prynth/prynth/pbridge/README.txt

# compile with the following command:

# cd src
# gcc -o pbridge pbridge.c -lwiringPi -llo

#move the binary to the upper directory
# mv ./pbridge ..

#requirements: liblo7, wiringPi, liblo-dev
