prynth/prynth/(threads)

Thread 1 (2016-12-07):

Resistors in schematics have no value specified

geriljaSA, 2016-12-07:
Hi.

The resistors and capacitors also in the schematic have no value (that I could find)

Can you please add to the bill of materials or the schematics the component values?

Thanks!

ifranco, 2016-12-07:
Hi. The resistors don't have specific values because you can use different values.

The resistors you find on the multiplexer boards are pull down resistors, so you should only populate them if you will be using switches instead of variable resistors. In that case, anything between 1K and 10K should be OK.

The capacitor is there mostly for good measure, in case you have big voltage drops. This is  conditioned by the application and shouldn't be necessary, unless you run into any instability when using sensors. In that case you will have to try different values and test.

The only resistor that needs a specific value is the midi out, which isn't really documented, since it doesn't follow the midi specification (3.3V instead of 5V). I tested it briefly but I'm not sure if it is reliable enough. If it is I will write about that feature in the future, at which point I will add the resistance value (by the way, so you know, it should be 47ohms, to have traditional MIDI on +3.3V).

Hope that helps.

geriljaSA, 2016-12-08:
Thanks! That helps a lot. I did not understand why the variable resistors seemed to need a pulldown resistor. But makes sense when you say they are only needed for switches. I just finished putting it together on prototyping board with one multiplexer and some variable resistors for a quick test... and it works 👍 Look forward to play more with this!

Thanks for the good work!

ifranco, 2016-12-08:
I would love to know what you're doing with it with Prynth.
My contacts are on the webpage (https://prynth.github.io/).

Thanks

Closed 2018-03-29.

Thread 3 (2018-04-25):

Changing sampling rate throught the sensor settings page

HarishJayanth, 2018-04-25:
Updating sample rate on the sensor settings page triggers a sensorSelected/ osc message instead of /sampleRate.

ifranco, 2018-04-25:
just fixed. Check it.

Closed 2018-05-10.

Thread 4 (2019-01-05):

osc address label on gui properties page

madskjeldgaard, 2019-01-05:
This is a tiny issue and more of a suggestion: Change the "Name:" label of a gui element in the properties part of the gui page to the same as the equivalent in the sensor page "OSC ADDRESS: /raspberrypi" for ease of use.

Thread 5 (2019-01-08):

Midi pulldown resistor value missing from documentation/eagle files

madskjeldgaard, 2019-01-08:
I am not able to find the value of resistor R1 by the midi output anywhere in the docs nor in the eagle files. Is it 33 ohms? Thanks

ifranco, 2019-01-09:
Hi Mads,Yes, you need to use something around those values.From my
calculations 47 Ohm is actually more appropriate.
Cheers,Ivan

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
