prynth/prynth/pcb/control/eagle/control.brd

## EAGLE design pcb/control/eagle/control.brd (2018-05-30)

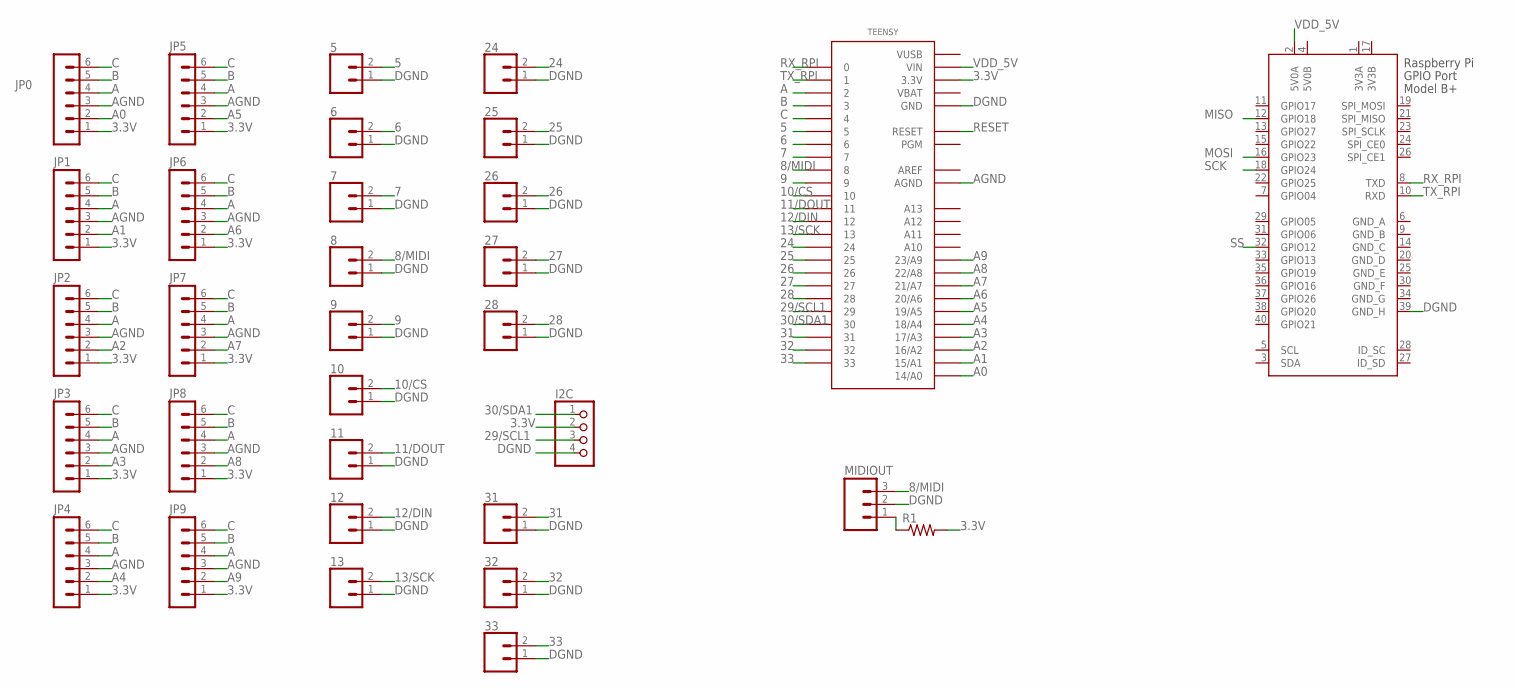
[picture p84: schematic control.sch]

Parts:
5, 6, 7, 8, 9, 10, 11, 12, 13, 24, 25, 26, 27, 28, 31, 32, 33: CONN_02; 1X02
I2C: PINHD-1X4; 1X04
JP0, JP1, JP2, JP3, JP4, JP5, JP6, JP7, JP8, JP9: MA06-1
MIDIOUT: M03PTH; 1X03
R1: RESISTORAXIAL-0.3; AXIAL-0.3
TEENSY: TEENSY_3.0_ALLPINS
X1: RASPI_BOARD_B+#_H; RASPI_BOARD_B+HAT

Connections:
3.3V: I2C.2, JP0.1, JP1.1, JP2.1, JP3.1, JP4.1, JP5.1, JP6.1, JP7.1, JP8.1, JP9.1, R1.P$2 (2), TEENSY.3.3V, TEENSY.3.3V1 (3.3V), TEENSY.3.3V2 (3.3V)
3V3A: X1.1 (3V3A)
3V3B: X1.17 (3V3B)
5: 5.2, TEENSY.5
5V0B: X1.4 (5V0B)
6: 6.2, TEENSY.6
7: 7.2, TEENSY.7
8/MIDI: 8.2, MIDIOUT.3, TEENSY.8
9: 9.2, TEENSY.9
10/CS: 10.2, TEENSY.10
11/DOUT: 11.2, TEENSY.11
12/DIN: 12.2, TEENSY.12
13/SCK: 13.2, TEENSY.13
24: 24.2, TEENSY.24
25: 25.2, TEENSY.25
26: 26.2, TEENSY.26
27: 27.2, TEENSY.27
28: 28.2, TEENSY.28
29/SCL1: I2C.3, TEENSY.29
30/SDA1: I2C.1, TEENSY.30
31: 31.2, TEENSY.31
32: 32.2, TEENSY.32
33: 33.2, TEENSY.33
A: JP0.4, JP1.4, JP2.4, JP3.4, JP4.4, JP5.4, JP6.4, JP7.4, JP8.4, JP9.4, TEENSY.2
A0: JP0.2, TEENSY.14/A0
A1: JP1.2, TEENSY.15/A1
A2: JP2.2, TEENSY.16/A2
A3: JP3.2, TEENSY.17/A3
A4: JP4.2, TEENSY.18/A4
A5: JP5.2, TEENSY.19/A5
A6: JP6.2, TEENSY.20/A6
A7: JP7.2, TEENSY.21/A7
A8: JP8.2, TEENSY.22/A8
A9: JP9.2, TEENSY.23/A9
AGND: JP0.3, JP1.3, JP2.3, JP3.3, JP4.3, JP5.3, JP6.3, JP7.3, JP8.3, JP9.3, TEENSY.AGND
AREF: TEENSY.AREF
B: JP0.5, JP1.5, JP2.5, JP3.5, JP4.5, JP5.5, JP6.5, JP7.5, JP8.5, JP9.5, TEENSY.3
C: JP0.6, JP1.6, JP2.6, JP3.6, JP4.6, JP5.6, JP6.6, JP7.6, JP8.6, JP9.6, TEENSY.4
DGND: 5.1, 6.1, 7.1, 8.1, 9.1, 10.1, 11.1, 12.1, 13.1, 24.1, 25.1, 26.1, 27.1, 28.1, 31.1, 32.1, 33.1, I2C.4, MIDIOUT.2, TEENSY.GND, TEENSY.GND1 (GND), TEENSY.GND2 (GND), X1.39 (GND_H)
GND_A: X1.6 (GND_A)
GND_B: X1.9 (GND_B)
GND_C: X1.14 (GND_C)
GND_D: X1.20 (GND_D)
GND_E: X1.25 (GND_E)
GND_F: X1.30 (GND_F)
GND_G: X1.34 (GND_G)
MISO: X1.12 (GPIO18)
MOSI: X1.16 (GPIO23)
unnamed: MIDIOUT.1, R1.P$1 (1)
RESET: TEENSY.RESET
RX_RPI: TEENSY.0, X1.8 (TXD)
SCK: X1.18 (GPIO24)
SS: X1.32 (GPIO12)
TX_RPI: TEENSY.1, X1.10 (RXD)
VBAT: TEENSY.VBAT
VDD_5V: TEENSY.VIN, X1.2 (5V0A)
VUSB: TEENSY.VUSB

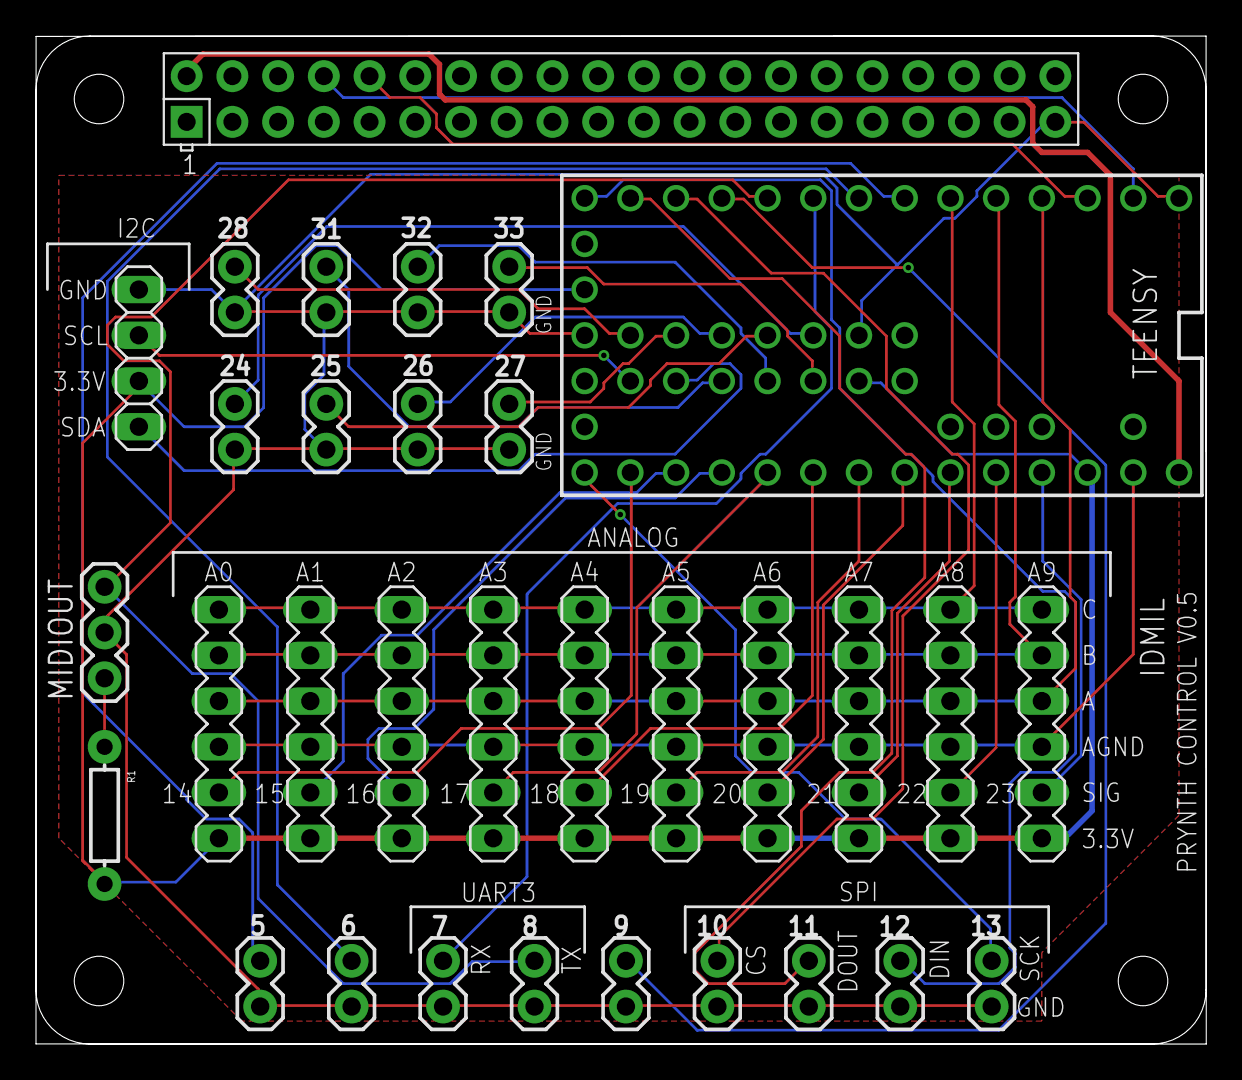
[picture p85: board control.brd from above]

Board: 2 copper layers, 65.0 x 56.0 mm, 32 parts (0 on the bottom side), 39 nets.
