prynth/prynth/pcb/muxi/eagle/muxi.brd

## EAGLE design pcb/muxi/eagle/muxi.brd (2018-05-30)

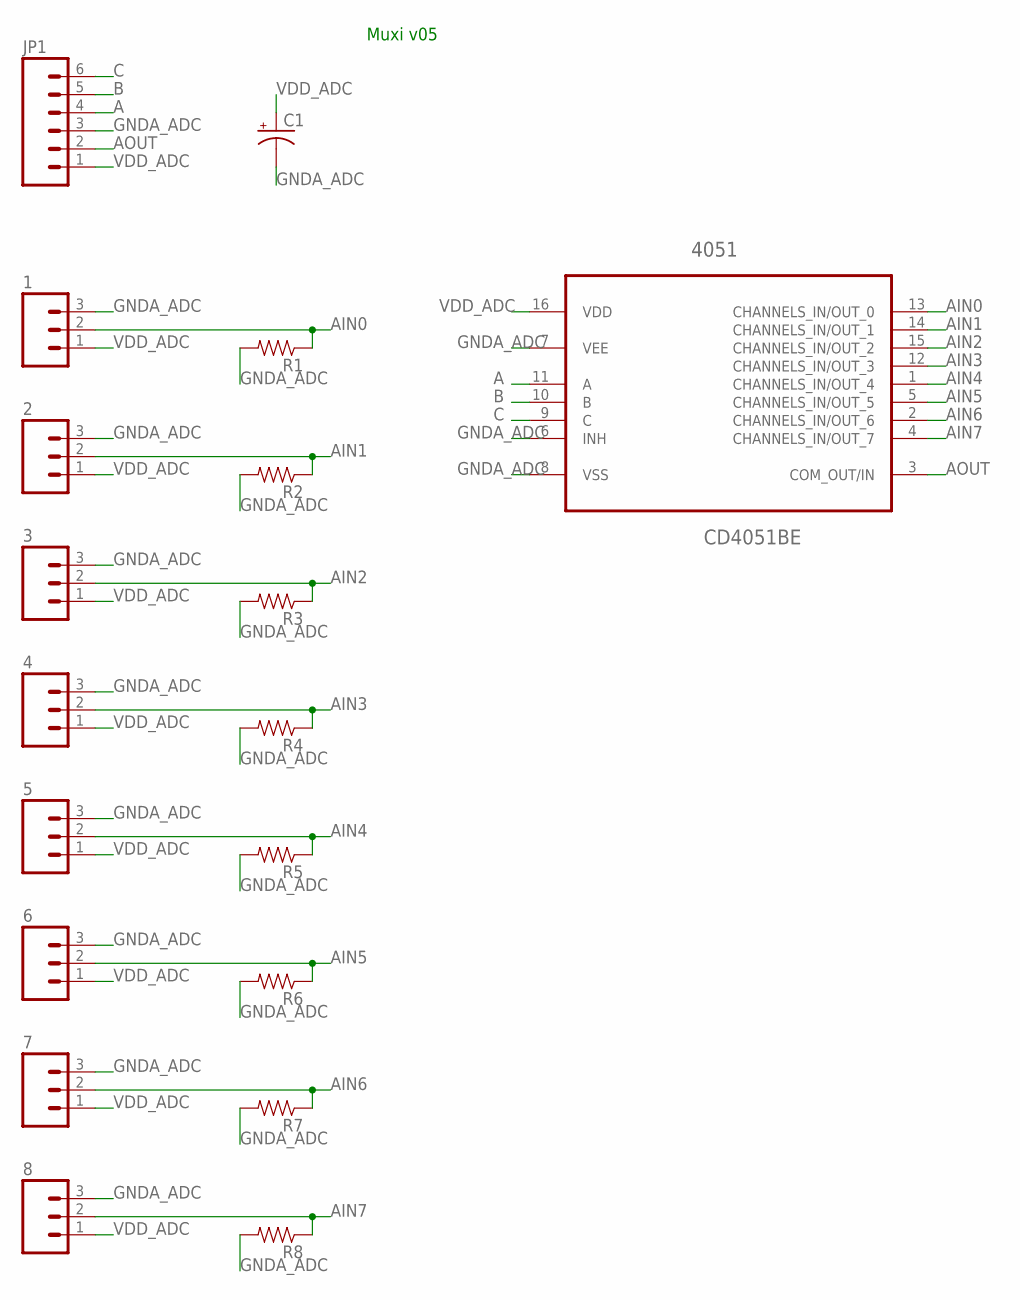
[picture p86: schematic muxi.sch]

Parts:
1, 2, 3, 4, 5, 6, 7, 8: M03PTH; 1X03
4051: CD4051BE; DIP254P762X508-16
C1: CAP_POLPTH2; CPOL-RADIAL-10UF-25V
JP1: M06NO_SILK; 1X06_NO_SILK
R1, R2, R3, R4, R5, R6, R7, R8: RESISTORAXIAL-0.3; AXIAL-0.3

Connections:
A: 4051.11 (A), JP1.4
AIN0: 1.2, 4051.13 (CHANNELS_IN/OUT_0), R1.P$1 (1)
AIN1: 2.2, 4051.14 (CHANNELS_IN/OUT_1), R2.P$1 (1)
AIN2: 3.2, 4051.15 (CHANNELS_IN/OUT_2), R3.P$1 (1)
AIN3: 4.2, 4051.12 (CHANNELS_IN/OUT_3), R4.P$1 (1)
AIN4: 5.2, 4051.1 (CHANNELS_IN/OUT_4), R5.P$1 (1)
AIN5: 6.2, 4051.5 (CHANNELS_IN/OUT_5), R6.P$1 (1)
AIN6: 7.2, 4051.2 (CHANNELS_IN/OUT_6), R7.P$1 (1)
AIN7: 8.2, 4051.4 (CHANNELS_IN/OUT_7), R8.P$1 (1)
AOUT: 4051.3 (COM_OUT/IN), JP1.2
B: 4051.10 (B), JP1.5
C: 4051.9 (C), JP1.6
GNDA_ADC: 1.3, 2.3, 3.3, 4.3, 5.3, 6.3, 7.3, 8.3, 4051.6 (INH), 4051.7 (VEE), 4051.8 (VSS), C1.2 (-), JP1.3, R1.P$2 (2), R2.P$2 (2), R3.P$2 (2), R4.P$2 (2), R5.P$2 (2), R6.P$2 (2), R7.P$2 (2), R8.P$2 (2)
VDD_ADC: 1.1, 2.1, 3.1, 4.1, 5.1, 6.1, 7.1, 8.1, 4051.16 (VDD), C1.1 (+), JP1.1

Notes on the sheet:
Muxi v05

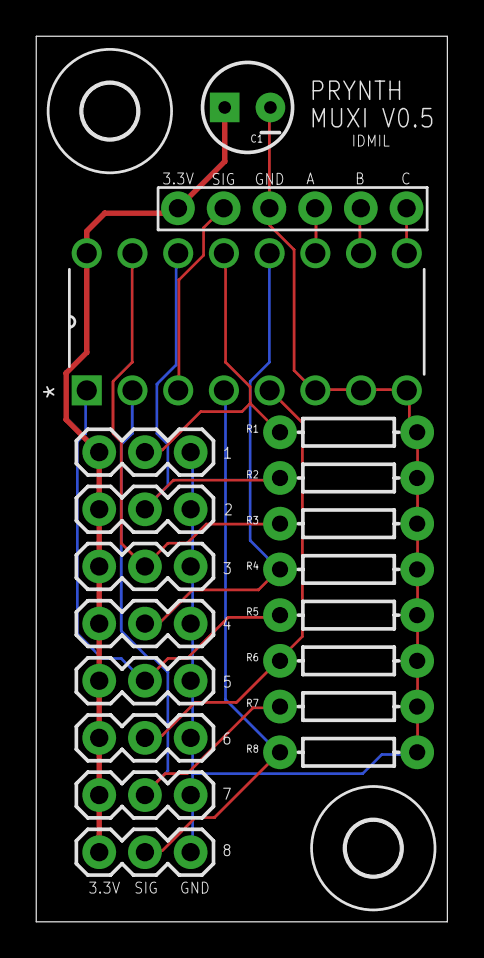
[picture p87: board muxi.brd from above]

Board: 2 copper layers, 22.8 x 49.2 mm, 21 parts (0 on the bottom side), 14 nets.

Other parts of the board:
U$1, U$2: 3,0
