prynth/prynth/(commit log)

2016-12-05 change default filtering settings on teensy code
    [muxi.brd, muxi_control.brd]
2016-12-13 updated gerbers
    [muxi.GBL, muxi.GBO, muxi.GBP, muxi.GBS, muxi.GTL, muxi.GTO, muxi.GTP, muxi.GTS]
2016-12-14 changed teensy filtering and comments
2017-08-02 new v04 server version
    [muxi.GBL, muxi.GBO, muxi.GBP, muxi.GBS, muxi.GTL, muxi.GTO, muxi.GTP, muxi.GTS]
2017-08-02 added serial2osc and teensy folders
2017-08-09 change sensor data target between language and server via prynth frontend
2017-08-17 changed serial2osc data structure to language so that sensor reference is included in path together with hostname
2017-08-22 restructured application directories
    [muxi.GBL, muxi.GBO, muxi.GBP, muxi.GBS, muxi.GTL, muxi.GTO, muxi.GTP, muxi.GTS]
2017-08-23 added hidden file filtering in file management
2017-08-25 added function and button to restart sclang
2017-08-25 changed nomenclature of button to restart sclang
2017-08-31 switched positions of system and restart sc buttons
2017-09-05 48 sample rate default
2018-02-12 execute block enclosed in parenthesis, search current word, auto-populate save dialog, textarea overload fix, codemirror highlight and execute block
2018-02-20 teensy legacy and new v04 have their own folders; increased default frequency on prynth_v04.ino
2018-03-03 added reboot confirmation prompt in some of the settings save buttons
2018-03-27 fixed socket io map issue
2018-05-19 restored pcb boards zip file
2018-05-30 added teensy source code zip for inernet distribution
2018-06-01 fixed button behaviour from impulse to button
2018-06-08 fixed problem with saving sensors wouldn't reload sensors.json
2018-06-08 reset of sensors.json
2018-08-29 substituted old mode switch by a Nexus object
2018-10-22 added Nexus number to gui, reduced button default size
2018-10-22 added gui button to index; removed Nexus Position test
2018-10-30 added option in settings for number of periods; fixed sc help launch from editor button
2020-12-30 fixed teensy code for new arduino (1.8.13)and teensy library (1.53)
    [Prynth.cpp]
2020-12-30 updated README and compressed new teensy code
