prynth/prynth/(notices)

Notices in the files:
pcb/muxi/eagle/muxi.brd:
CC BY-SA 3.0
parts and their libraries:
SparkFun-Connectors: Licensing: Creative Commons ShareAlike 4.0 International - https://creativecommons.org/licenses/by-sa/4.0
